shackspace/u2f-zero/hardware/case/clippable/with USB connector/pics/IMG_20170323_214509.jpg

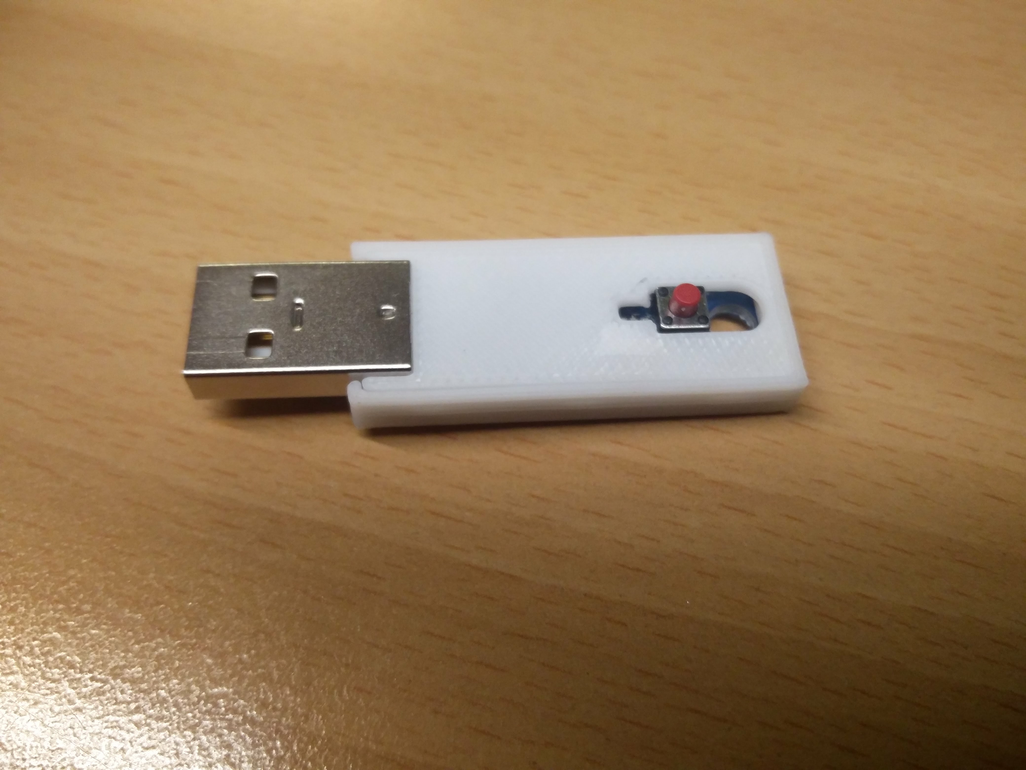
hardware/case/clippable/with USB connector/pics/IMG_20170323_214509.jpg
