shackspace/u2f-zero/hardware/case/clippable/with USB connector/pics/case_3d.png

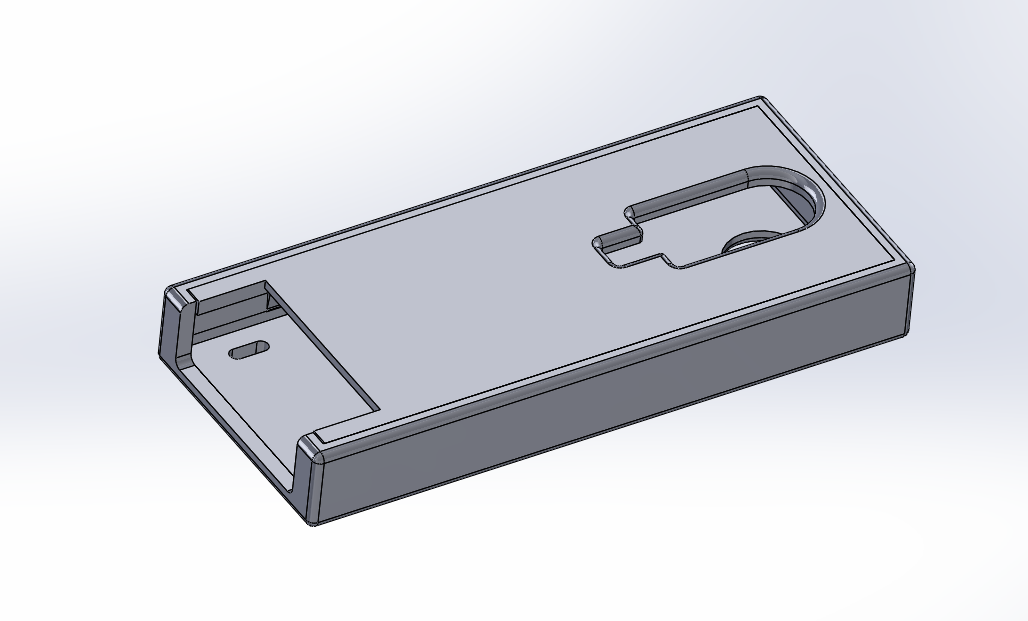
hardware/case/clippable/with USB connector/pics/case_3d.png
