shackspace/u2f-zero/hardware/case/clippable/with USB connector/pics/case_bottom.png

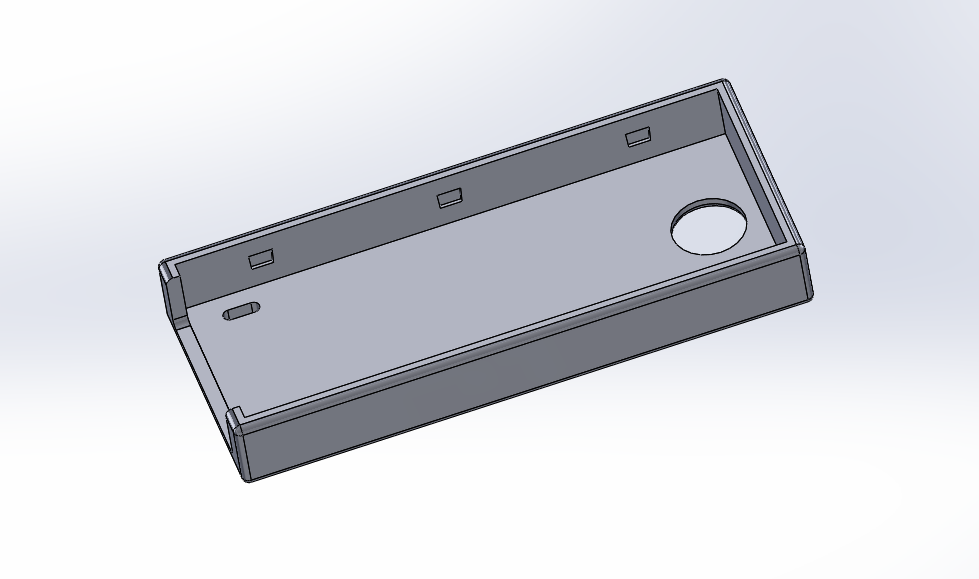
hardware/case/clippable/with USB connector/pics/case_bottom.png
