shackspace/u2f-zero/hardware/case/clippable/with USB connector/pics/case_top.png

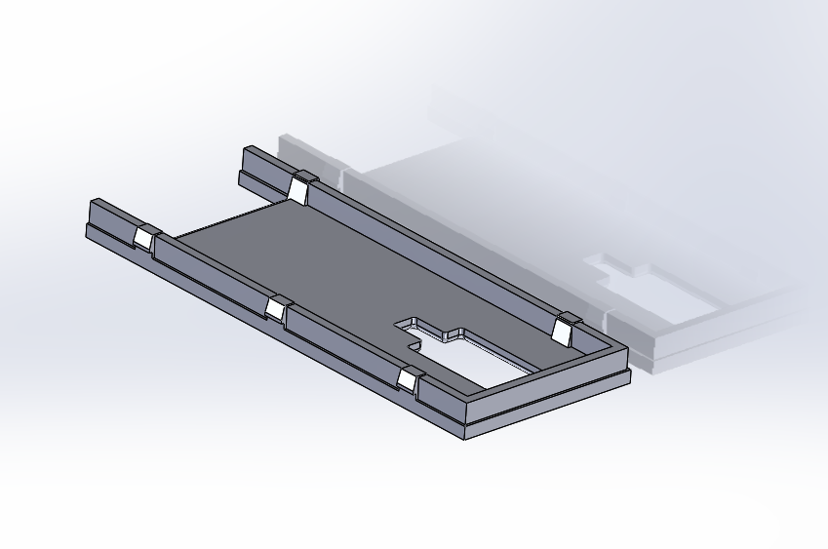
hardware/case/clippable/with USB connector/pics/case_top.png
