shackspace/u2f-zero/hardware/case/clippable/with USB connector/pics/IMG_20170323_215312.jpg

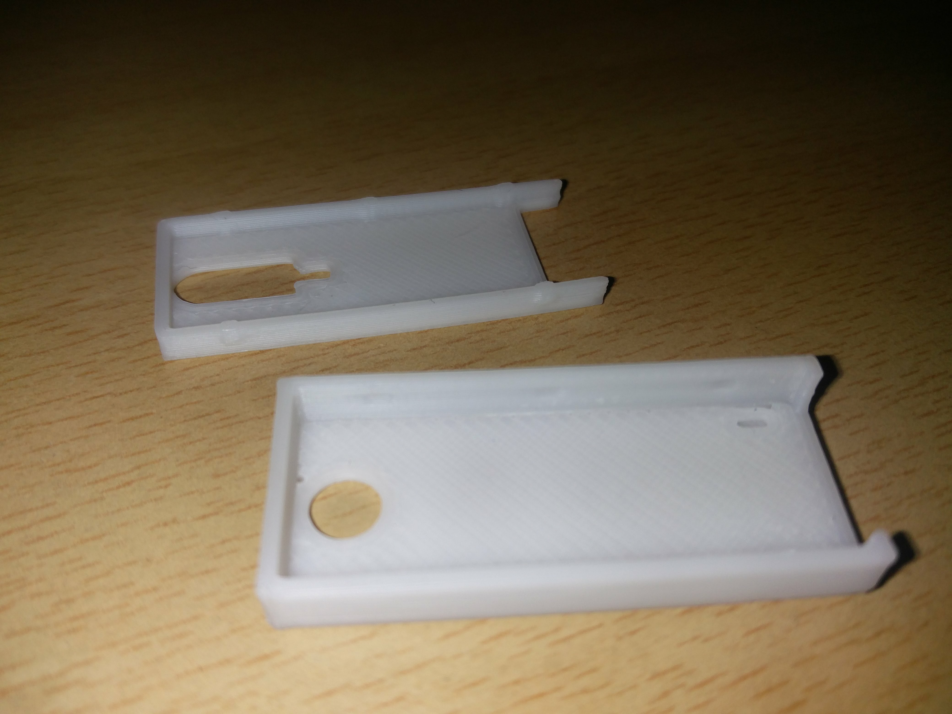
hardware/case/clippable/with USB connector/pics/IMG_20170323_215312.jpg
