shackspace/u2f-zero/hardware/case/clippable/with USB connector/u2f_assembled.SLDASM

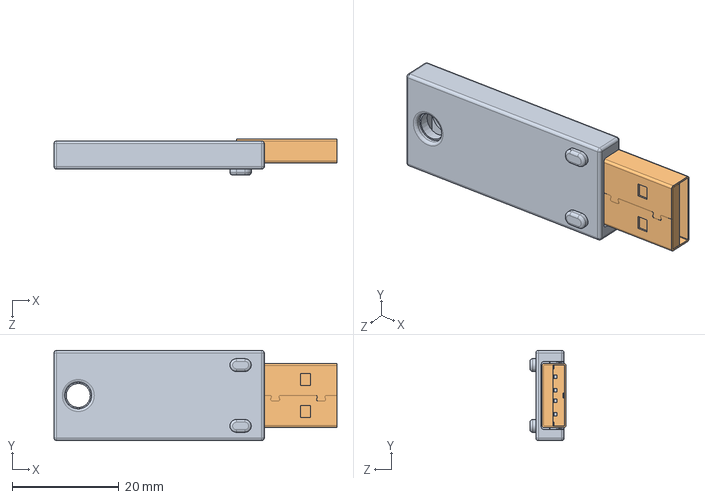
[picture p8: CAD file, 2017-03-26]
hardware/case/clippable/with USB connector/u2f_assembled.SLDASM
53.0 x 16.9 x 6.77 mm
case_bottom
USB_plug_MOLEX_0480371000
