shackspace/u2f-zero/hardware/case/clippable/with USB connector/3dp/case_bottom_without_USB_holder_covers_for_easier_printing.STL

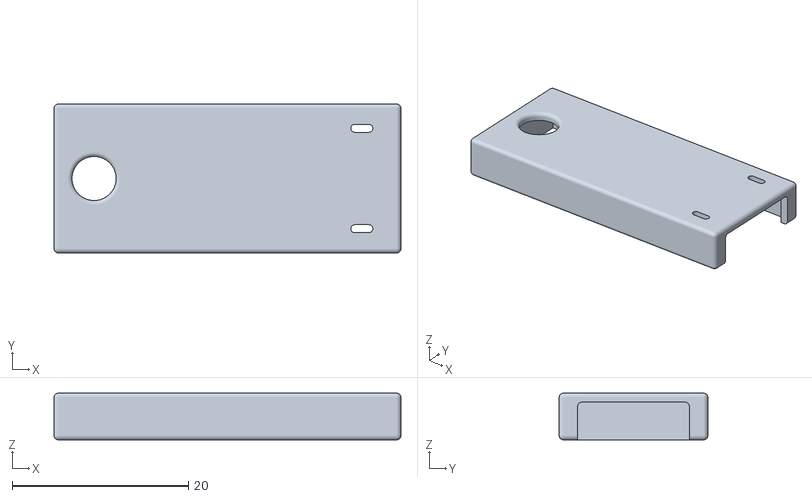
[picture p9: CAD file, 2017-03-26]
hardware/case/clippable/with USB connector/3dp/case_bottom_without_USB_holder_covers_for_easier_printing.STL
39.4 x 16.9 x 5.30
