shackspace/u2f-zero/hardware/case/clippable/with USB connector/3dp/case_top.STL

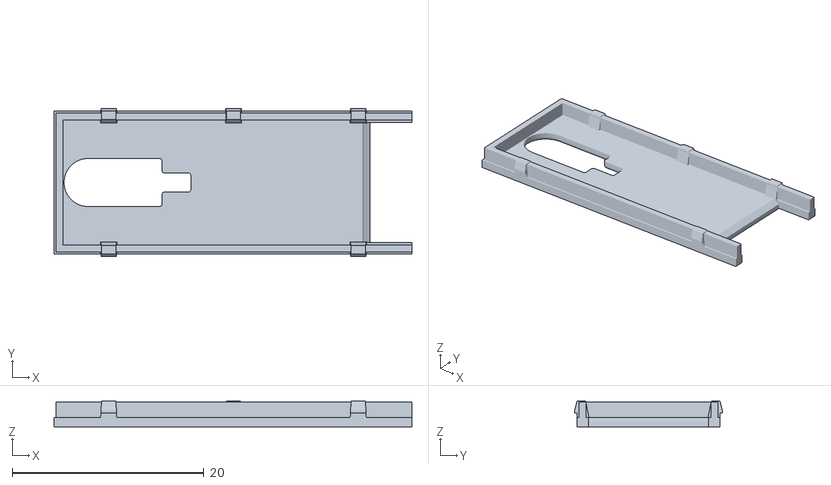
[picture p10: CAD file, 2017-03-26]
hardware/case/clippable/with USB connector/3dp/case_top.STL
37.3 x 15.4 x 2.70
