shackspace/u2f-zero/hardware/case/clippable/with USB connector/case_bottom.SLDPRT

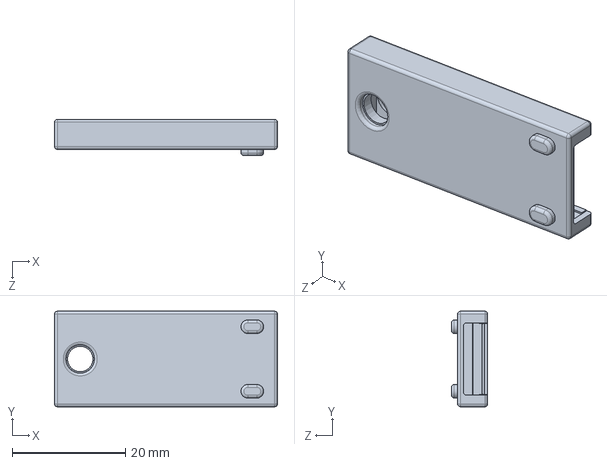
[picture p11: CAD file, 2017-03-26]
hardware/case/clippable/with USB connector/case_bottom.SLDPRT
39.4 x 16.9 x 6.40 mm
