shackspace/u2f-zero/hardware/case/clippable/with USB connector/3dp/case_bottom.STL

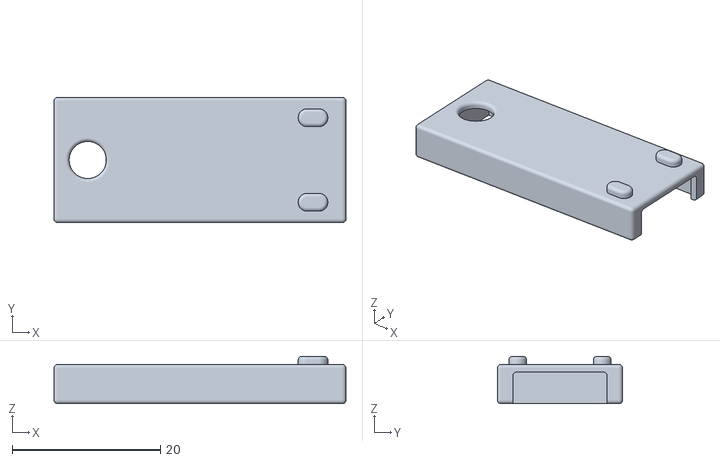
[picture p12: CAD file, 2017-03-26]
hardware/case/clippable/with USB connector/3dp/case_bottom.STL
39.4 x 16.9 x 6.40
