shackspace/u2f-zero/hardware/case/clippable/with USB connector/USB_plug_MOLEX_0480371000.SLDPRT

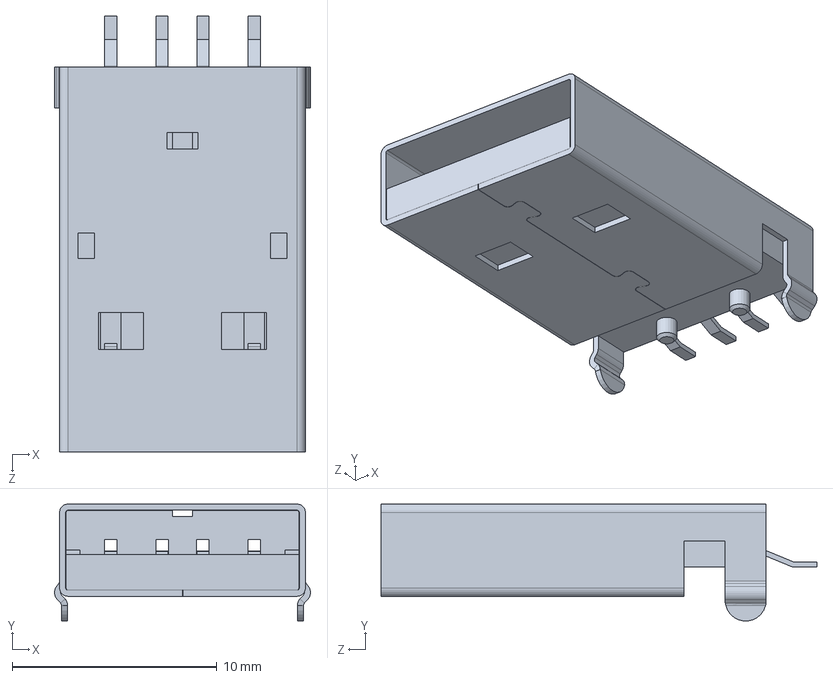
[picture p13: CAD file, 2017-03-26]
hardware/case/clippable/with USB connector/USB_plug_MOLEX_0480371000.SLDPRT
12.5 x 5.70 x 21.3 mm
