shackspace/u2f-zero/hardware/u2f-zero.kicad_pcb

## KiCad design hardware/u2f-zero.kicad_pcb (2016-10-03)

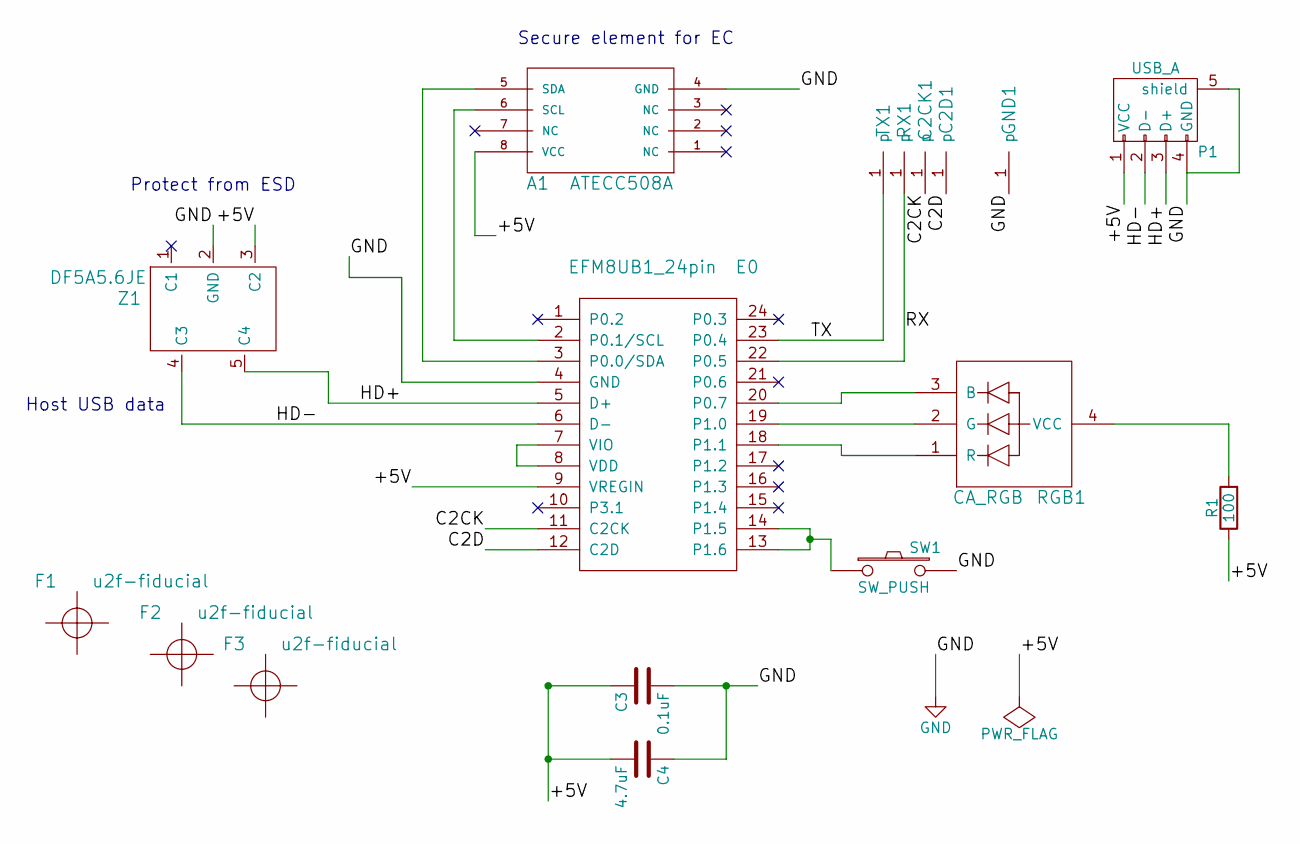
[picture p14: schematic u2f-zero.sch]

Parts:
A1: ATECC508A; SOIC-8_3.9x4.9mm_Pitch1.27mm; MFG Part Num ATECC508A-SSHDA-B
C2CK1, C2D1: debug-pin; debug
C3: 0.1uF; C_0402; MFG Part Num CL05A104MP5NNNC
C4: 4.7uF; C_0603; MFG Part Num CL10B475KQ8NQNC
E0: EFM8UB1_24pin; QSOP-24_3.9x8.7mm_Pitch0.635mm_fat; MFG Part Num EFM8UB11F16G-C-QSOP24
F1, F2, F3: u2f-fiducial
GND1: debug-pin; debug
P1: USB_A; USB_A_CON
R1: 100; R_0603; MFG Part Num CRCW0603100RFKEA
RGB1: CA_RGB; LED-0606; MFG Part Num LTST-C19HE1WT
RX1: debug-pin; debug
SW1: SW_PUSH; u2f-button; MFG Part Num TL3305AF260QG
TX1: debug-pin; debug
Z1: DF5A5.6JE; SOT-553; MFG Part Num DF5A5.6JE,LM

Connections:
/+5V: A1.8 (VCC), C3.1, C4.2, E0.9 (VREGIN), P1.1 (VCC), R1.1, Z1.3 (C2)
/C2CK: C2CK1.1, E0.11 (C2CK)
/C2D: C2D1.1, E0.12 (C2D)
/HD+: E0.5 (D+), P1.3 (D+), Z1.5 (C4)
/HD-: E0.6 (D-), P1.2 (D-), Z1.4 (C3)
/RX: E0.22 (P0.5), RX1.1
/TX: E0.23 (P0.4), TX1.1
GND: A1.4 (GND), C3.2, C4.1, E0.4 (GND), GND1.1, P1.4 (GND), P1.5 (shield), SW1.2, Z1.2 (GND)
unnamed: A1.5 (SDA), E0.3 (P0.0/SDA)
unnamed: A1.6 (SCL), E0.2 (P0.1/SCL)
unnamed: E0.7 (VIO), E0.8 (VDD)
unnamed: E0.13 (P1.6), E0.14 (P1.5), SW1.1
unnamed: E0.18 (P1.1), RGB1.1 (R)
unnamed: E0.19 (P1.0), RGB1.2 (G)
unnamed: E0.20 (P0.7), RGB1.3 (B)
unnamed: R1.2, RGB1.4 (VCC)

Notes on the sheet:
Protect from ESD
Host USB data
Secure element for EC

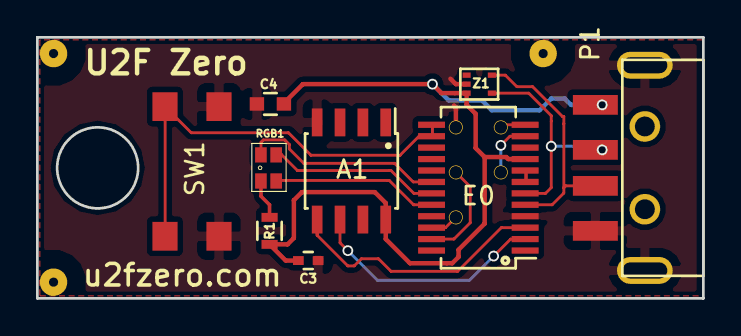
[picture p15: board u2f-zero.kicad_pcb from above]

Board: 2 copper layers, 37.0 x 14.5 mm, 17 parts (0 on the bottom side), 16 nets.
