shackspace/u2f-zero/(commit log)

2016-10-03 changed usb connector from pcb connector to surface soldered connector
    [u2f-zero.kicad_pcb, u2f-zero.sch]
2016-10-22 first attempt at creating a 3d printable (sla/sls) clippable case
    next: test print, modify, order?!
    [USB_plug_MOLEX_0480371000.SLDPRT, case_bottom.SLDPRT, case_bottom.STL, case_top.STL, u2f_assembled.SLDASM]
2017-02-07 changed push button hole position
    [case_bottom.SLDPRT, case_bottom.STL, case_top.STL, u2f_assembled.SLDASM]
2017-03-23 case complete (USB plug version)
    Testprints, minor changes made. Done.
    [USB_plug_MOLEX_0480371000.SLDPRT, case_bottom.SLDPRT, case_bottom.STL, case_bottom_without_USB_holder_covers_for_easier_printing.STL, case_top.STL, u2f_assembled.SLDASM]
